IdoBH123/Temperature-Control/Project - Temp Control - Ohad, Rafi and Ido.pdf

# מעבדת חשמל ואלקטרוניקה 2

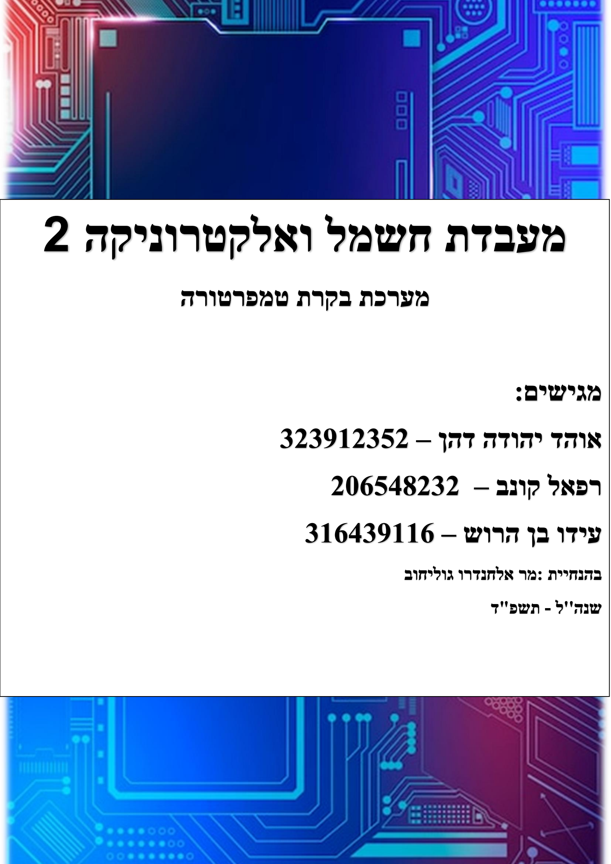
[picture p1: page 1]

# מערכת בקרת טמפרטורה

# מגישים:

# אוהד יהודה דהן – 323912352

# רפאל קונב – 206548232

# עידו בן הרוש – 316439116

## בהנחיית :מר אלחנדרו גוליחוב

## שנה''ל - תשפ"ד

מבוא
- מקדמה

הפרויקט שבחרנו הוא מערכת בקרת מיזוג )טמפ'( ה"נשלטת" על ידי קלט המשתמש שמכתיב מה יהיו תנאי החדר הרצויים.

- בחירת הנושא

לאחר חשיבה ממושכת, בחרנו בנושא זה מכיוון שחשנו מאותגרים משימוש ברכיבים חדשים ולא מוכרים וראינו בזאת כהזדמנות פז להעשיר את הידע שלנו כפרויקטורים ומהנדסים.

יתר על כן, רצינו לבחור בנושא אשר משתמש בידע קודם שלנו מקורסים אחרים )כגון מידול וסימולציה של מערכות דינמיות, מיתוג, תקבילית( על ידי שימוש פיזי ברכיבים שנלמדו רק באופן תיאורטי בהרצאות )כגון ממירים, מערכות צירופים, מגברי שרת וכו'(.

- ציפיות ראשוניות ומטרה

הציפיות שלנו הן שנעשיר את הידע שלנו ו"נצא" מהפרויקט כמהנדסים טובים יותר, שנתמודד בהצלחה עם עבודה בצוות, לווא דווקא עם אנשים בעלי אותו "קו חשיבה" ,ונלמד להיות מכילים וגמישים מבחינת עבודה בצוות, וכמובן שנדע לעסוק טוב יותר עם רכיבים אלקטרוניים נפוצים בתעשייה.

מטרתנו הסופית היא בניית מערכת אוטונומית ללא תקלות אשר שולטת באקלים בחדר מקרוב ומרחוק.

תוכן עניינים

## Contents

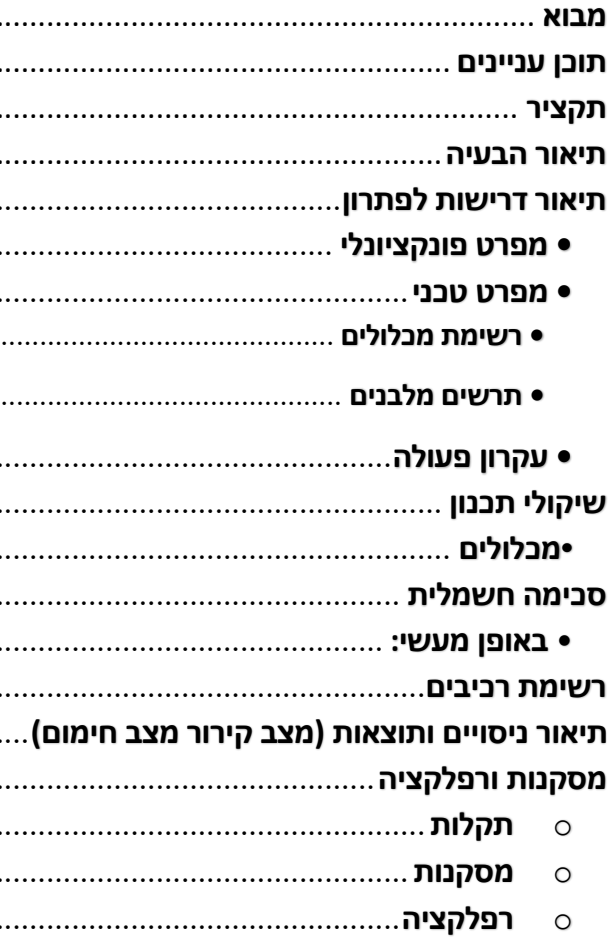
[picture p2: figure]

- רשימת מכלולים 5 |
- תרשים מלבנים 5 |

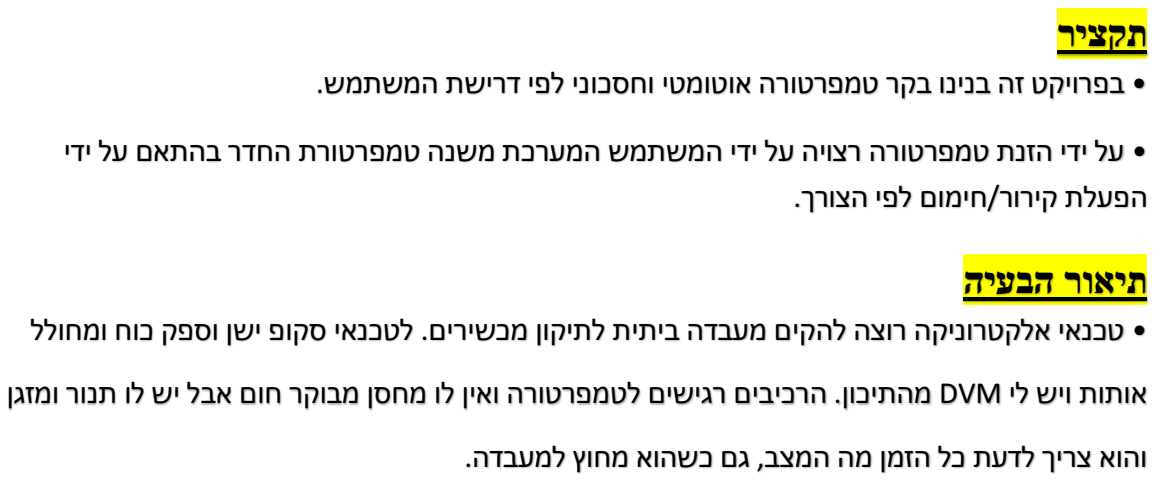
[picture p3: figure]
תקציר; הפעלת קירור/חימום לפי הצורך.; תיאור הבעיה

- בפרויקט זה בנינו בקר טמפרטורה אוטומטי וחסכוני לפי דרישת המשתמש.
- על ידי הזנת טמפרטורה רצויה על ידי המשתמש המערכת משנה טמפרטורת החדר בהתאם על ידי
- טכנאי אלקטרוניקה רוצה להקים מעבדה ביתית לתיקון מכשירים. לטכנאי סקופ ישן וספק כוח ומחולל

אותות ויש לי DVM מהתיכון. הרכיבים רגישים לטמפרטורה ואין לו מחסן מבוקר חום אבל יש לו תנור ומזגן

והוא צריך לדעת כל הזמן מה המצב, גם כשהוא מחוץ למעבדה.

נחלק את הבעיה לבעיות הנדסיות:

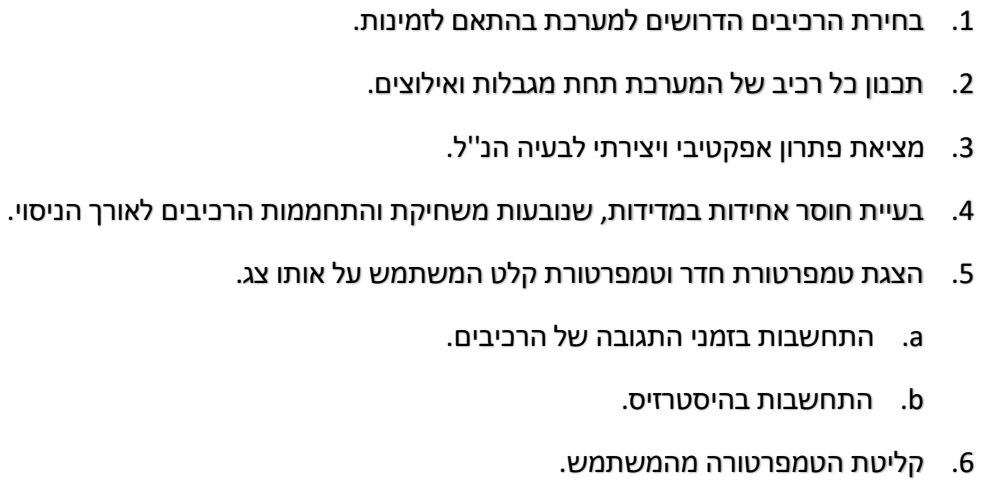
[picture p4: figure]
a. התחשבות בזמני התגובה של הרכיבים.; b. התחשבות בהיסטרזיס.; .6 קליטת הטמפרטורה מהמשתמש.

.1 בחירת הרכיבים הדרושים למערכת בהתאם לזמינות.

.2 תכנון כל רכיב של המערכת תחת מגבלות ואילוצים.

.3 מציאת פתרון אפקטיבי ויצירתי לבעיה הנ''ל.

.4 בעיית חוסר אחידות במדידות, שנובעות משחיקת והתחממות הרכיבים לאורך הניסוי.

.5 הצגת טמפרטורת חדר וטמפרטורת קלט המשתמש על אותו צג.

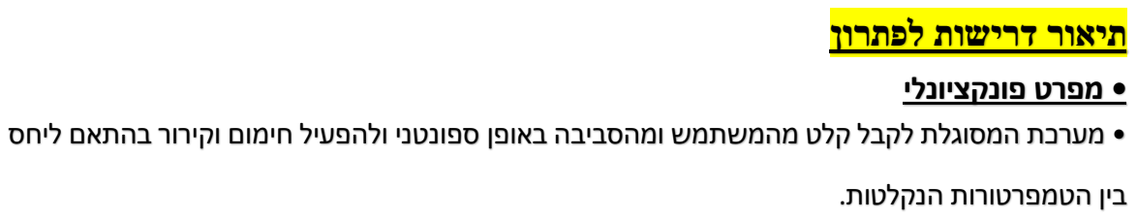
[picture p5: figure]
תיאור דרישות לפתרון; • מפרט פונקציונלי; בין הטמפרטורות הנקלטות.

- מערכת המסוגלת לקבל קלט מהמשתמש ומהסביבה באופן ספונטני ולהפעיל חימום וקירור בהתאם ליחס
- הצגת הטמפרטורות על צג אשר מחליף בין הצגת הטמפרטורה בחדר ובין הטמפרטורה הרצויה על ידי

המשתמש כל מספר שניות באופן אוטומטי, ואפשרות להצגת הטמפרטורה הרצויה על ידי המשתמש בלבד.

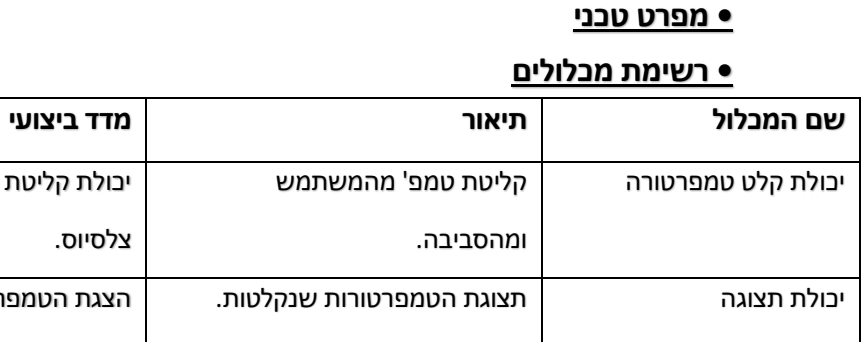
[picture p6: figure]
• מפרט טכני; • רשימת מכלולים; שם המכלול תיאור מדד ביצועי
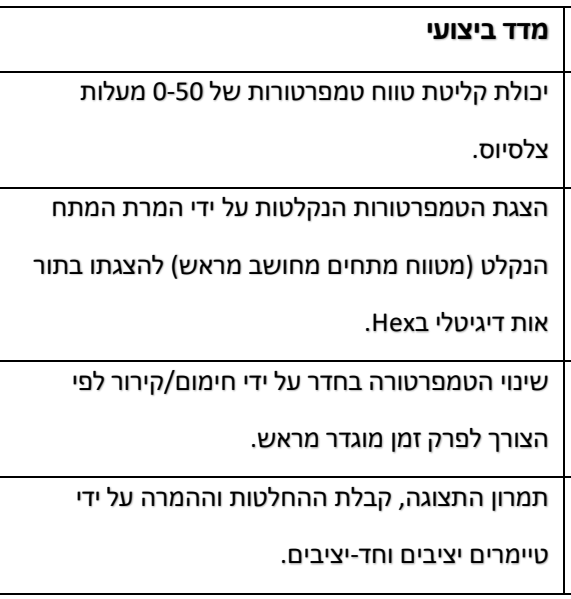
[picture p7: figure]

יכולת קליטת טווח טמפרטורות של 0-50 מעלות צלסיוס. | ומהסביבה. | יכולת קלט טמפרטורה קליטת טמפ' מהמשתמש
הנקלט )מטווח מתחים מחושב מראש( להצגתו בתור אות דיגיטלי בHex. | | יכולת תצוגה תצוגת הטמפרטורות שנקלטות. הצגת הטמפרטורות הנקלטות על ידי המרת המתח
הצורך לפרק זמן מוגדר מראש. | | יכולת קבלת החלטות שינוי הטמפרטורה בחדר. שינוי הטמפרטורה בחדר על ידי חימום/קירור לפי
טיימרים יציבים וחד-יציבים. | | יכולת תזמון ו-Switching תמרון רכיבי המעגל. תמרון התצוגה, קבלת ההחלטות וההמרה על ידי
- תרשים מלבנים

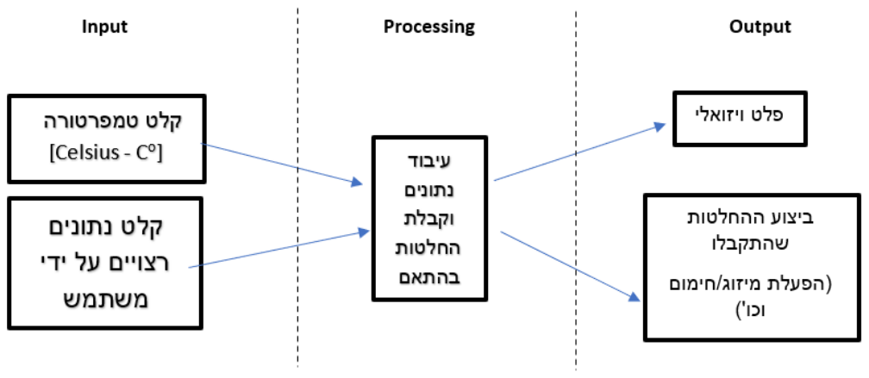
[picture p8: figure]

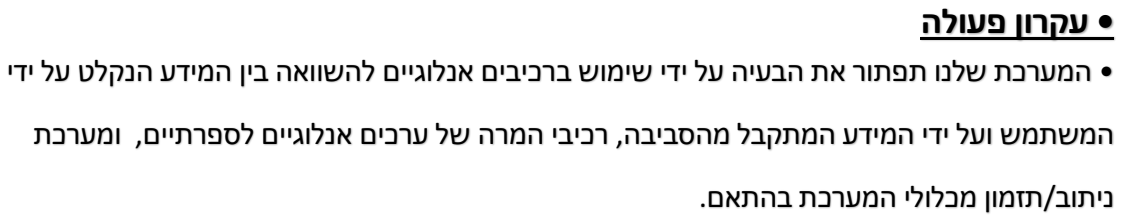
[picture p9: figure]
• עקרון פעולה; ניתוב/תזמון מכלולי המערכת בהתאם.

- המערכת שלנו תפתור את הבעיה על ידי שימוש ברכיבים אנלוגיים להשוואה בין המידע הנקלט על ידי

המשתמש ועל ידי המידע המתקבל מהסביבה, רכיבי המרה של ערכים אנלוגיים לספרתיים, ומערכת

- במרווחי זמן ידועים, המערכת קולטת מידע מהסביבה ומהמשתמש, תעבד ותשווה את הנתונים הנקלטים

ותקבל החלטות בהתאם, כלומר תבחר אם לחמם או לקרר את החדר לפי הצורך. בנוסף, תציג המערכת את

הנתונים הנקלטים ואת השינויים המתרחשים במרווחי הזמן הידועים.

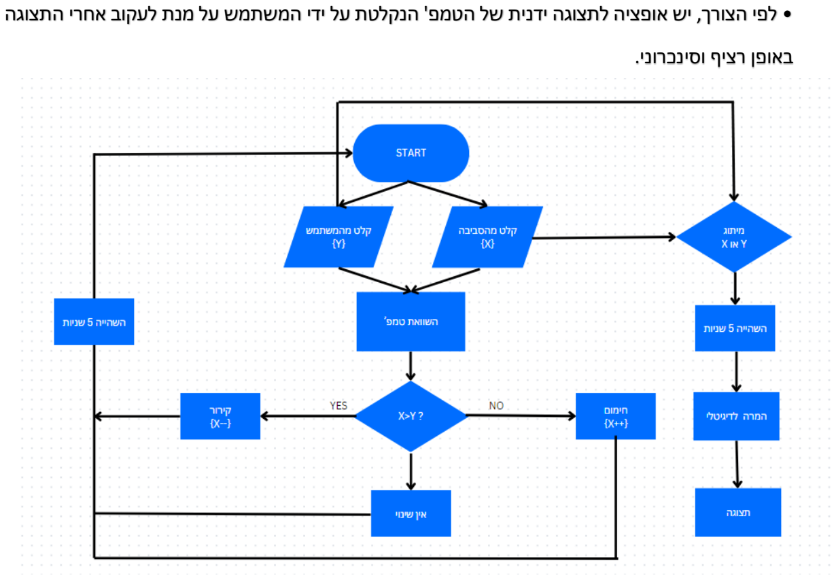
[picture p10: figure]
באופן רציף וסינכרוני.

- לפי הצורך, יש אופציה לתצוגה ידנית של הטמפ' הנקלטת על ידי המשתמש על מנת לעקוב אחרי התצוגה

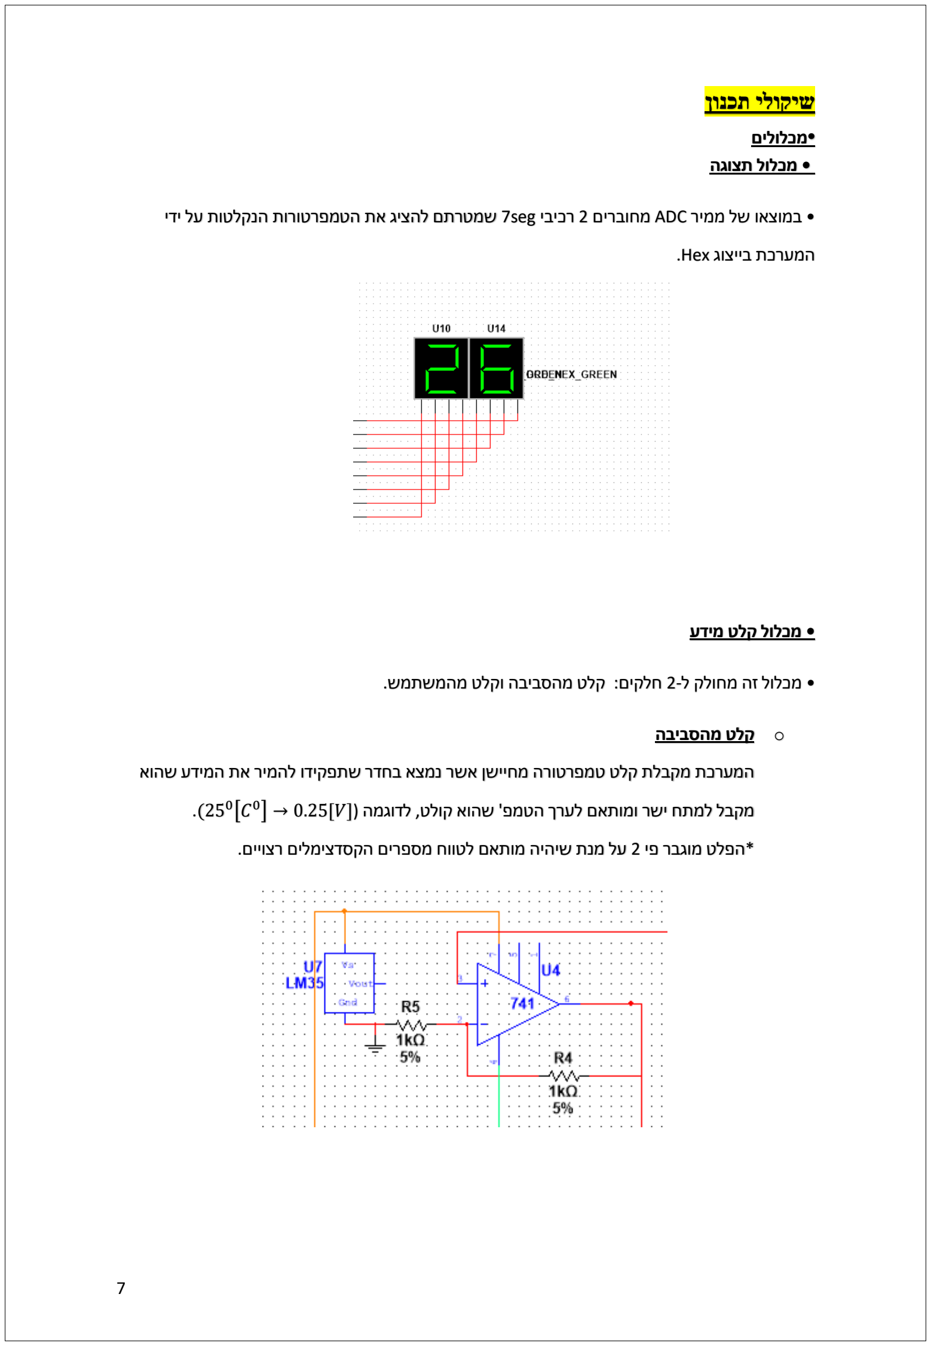
[picture p11: page 7]

שיקולי תכנון

•מכלולים
- מכלול תצוגה
- במוצאו של ממיר ADC מחוברים 2 רכיבי seg7 שמטרתם להציג את הטמפרטורות הנקלטות על ידי

המערכת בייצוג Hex.

- מכלול קלט מידע
- מכלול זה מחולק ל2- חלקים: קלט מהסביבה וקלט מהמשתמש.
- קלט מהסביבה

המערכת מקבלת קלט טמפרטורה מחיישן אשר נמצא בחדר שתפקידו להמיר את המידע שהוא

0 | מקבל למתח ישר ומותאם לערך הטמפ' שהוא קולט, לדוגמה ) 25)
ൣC

0
. | ൧ → 0.25[V]

*הפלט מוגבר פי 2 על מנת שיהיה מותאם לטווח מספרים הקסדצימלים רצויים.

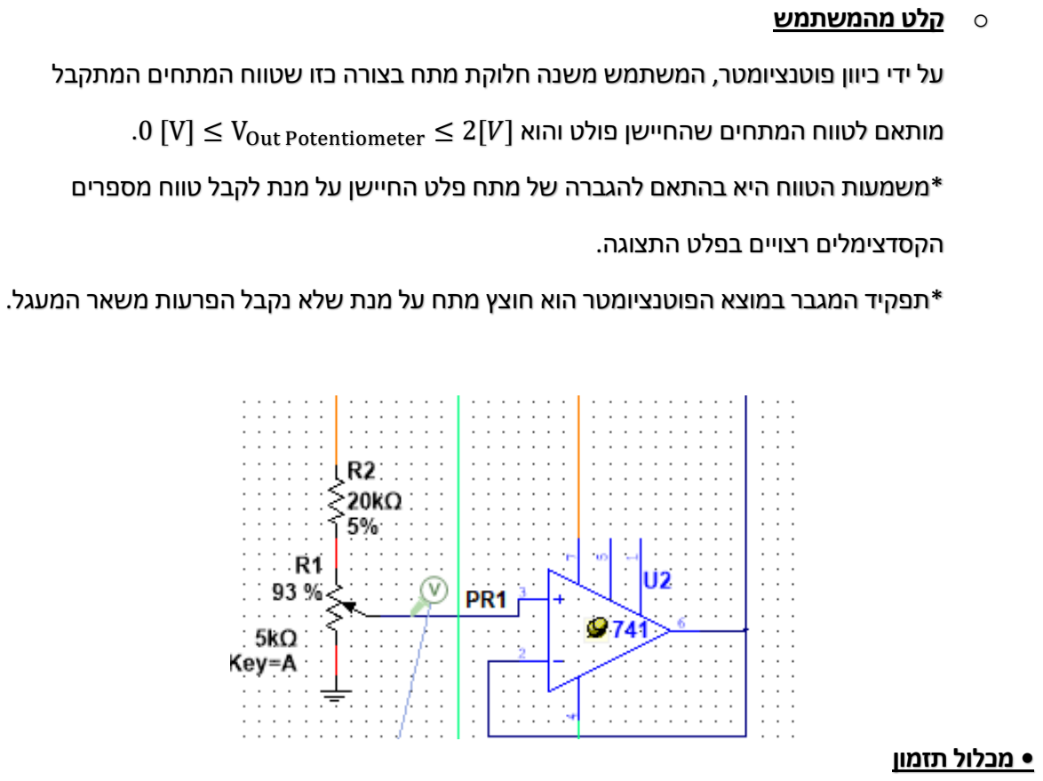
[picture p12: figure]
• קלט מהמשתמש; הקסדצימלים רצויים בפלט התצוגה.; • מכלול תזמון

על ידי כיוון פוטנציומטר, המשתמש משנה חלוקת מתח בצורה כזו שטווח המתחים המתקבל

מותאם לטווח המתחים שהחיישן פולט והוא []2 ≥ Potentiometer VOut] ≤ V [.0

*משמעות הטווח היא בהתאם להגברה של מתח פלט החיישן על מנת לקבל טווח מספרים

*תפקיד המגבר במוצא הפוטנציומטר הוא חוצץ מתח על מנת שלא נקבל הפרעות משאר המעגל.

- שלושה רכיבי 555LM, כאשר שניים מהם מחוברים באופן חד-יציב והנותר מחובר באופן אל-יציב.

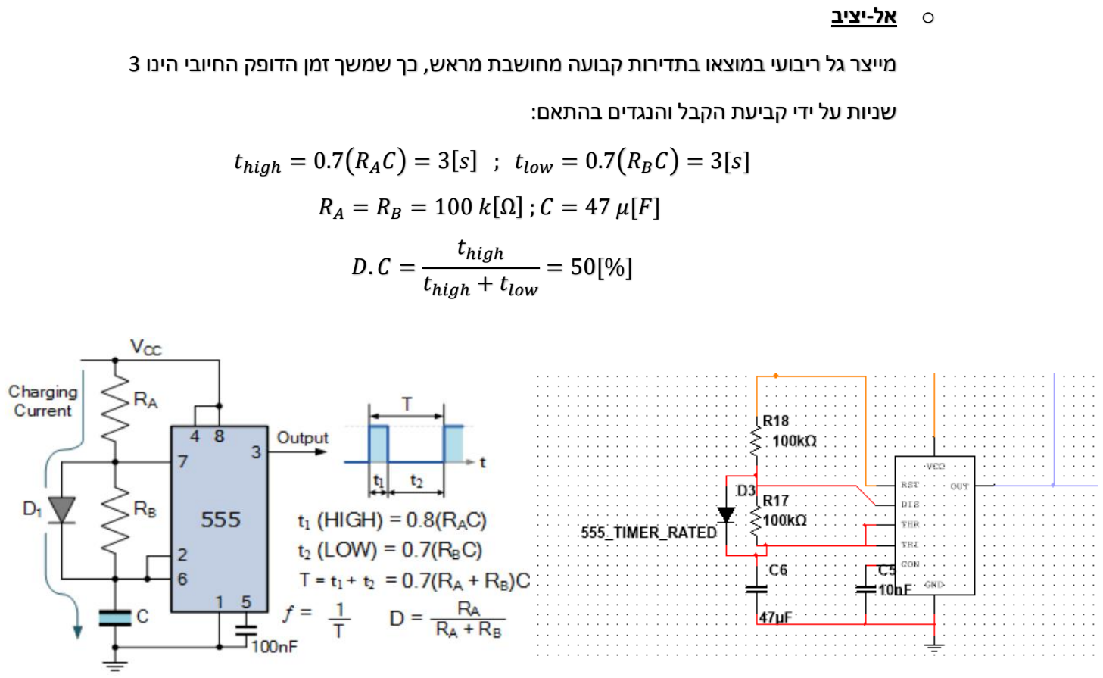
[picture p13: figure]
• אל-יציב; שניות על ידי קביעת הקבל והנגדים בהתאם:; tℎigℎ; tℎigℎ + tlow

מייצר גל ריבועי במוצאו בתדירות קבועה מחושבת מראש, כך שמשך זמן הדופק החיובי הינו 3

tℎigℎ = 0.7൫RAC൯ = 3[s] ; tlow = 0.7൫RBC൯ = 3[s]

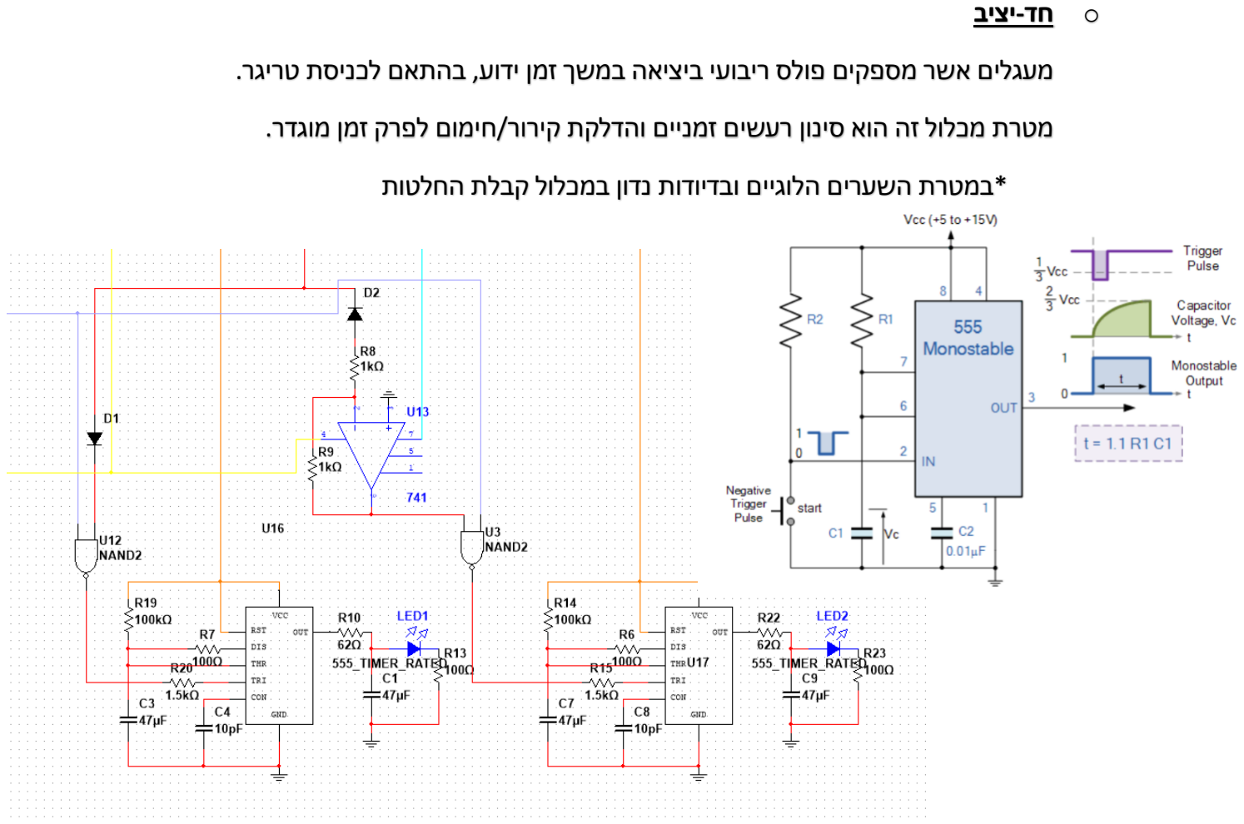
[picture p14: figure]
• חד-יציב

מעגלים אשר מספקים פולס ריבועי ביציאה במשך זמן ידוע, בהתאם לכניסת טריגר.

מטרת מכלול זה הוא סינון רעשים זמניים והדלקת קירור/חימום לפרק זמן מוגדר.

*במטרת השערים הלוגיים ובדיודות נדון במכלול קבלת החלטות

- מכלול עיבוד נתונים וקבלת החלטות
- מכלול זה מורכב מממסר V5 , דיודות, משווים שערים לוגיים ומפסק ידני. נדון במטרת כל אחד בנפרד:

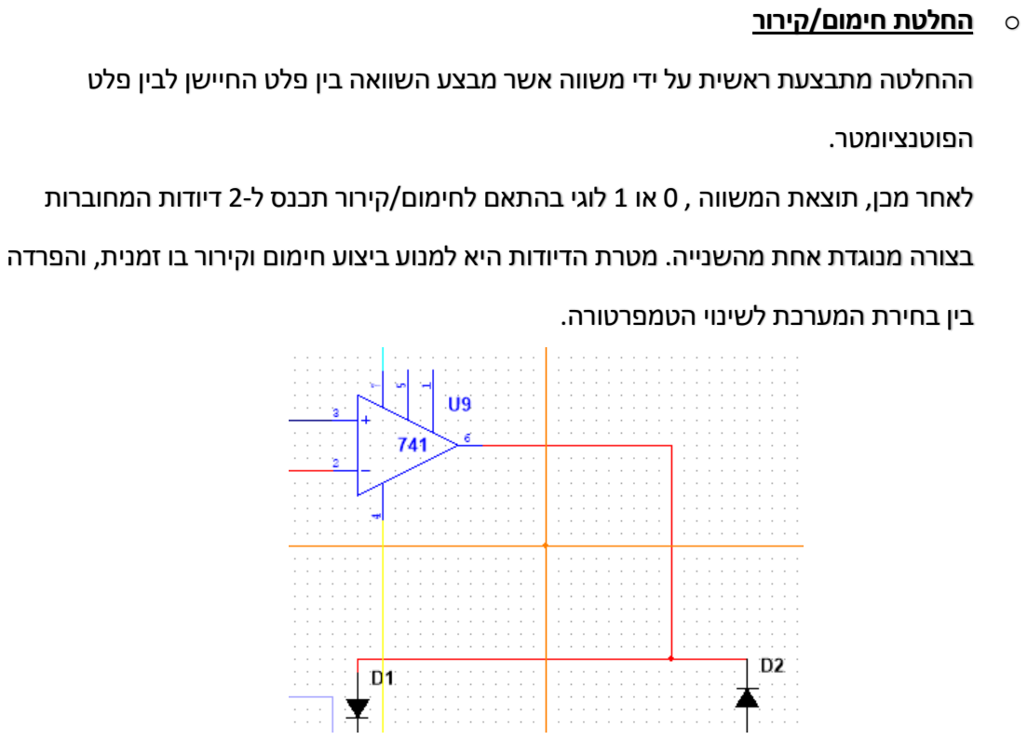
[picture p15: figure]
• החלטת חימום/קירור; הפוטנציומטר.; בין בחירת המערכת לשינוי הטמפרטורה.

ההחלטה מתבצעת ראשית על ידי משווה אשר מבצע השוואה בין פלט החיישן לבין פלט

לאחר מכן, תוצאת המשווה , 0 או 1 לוגי בהתאם לחימום/קירור תכנס ל2- דיודות המחוברות

בצורה מנוגדת אחת מהשנייה. מטרת הדיודות היא למנוע ביצוע חימום וקירור בו זמנית, והפרדה

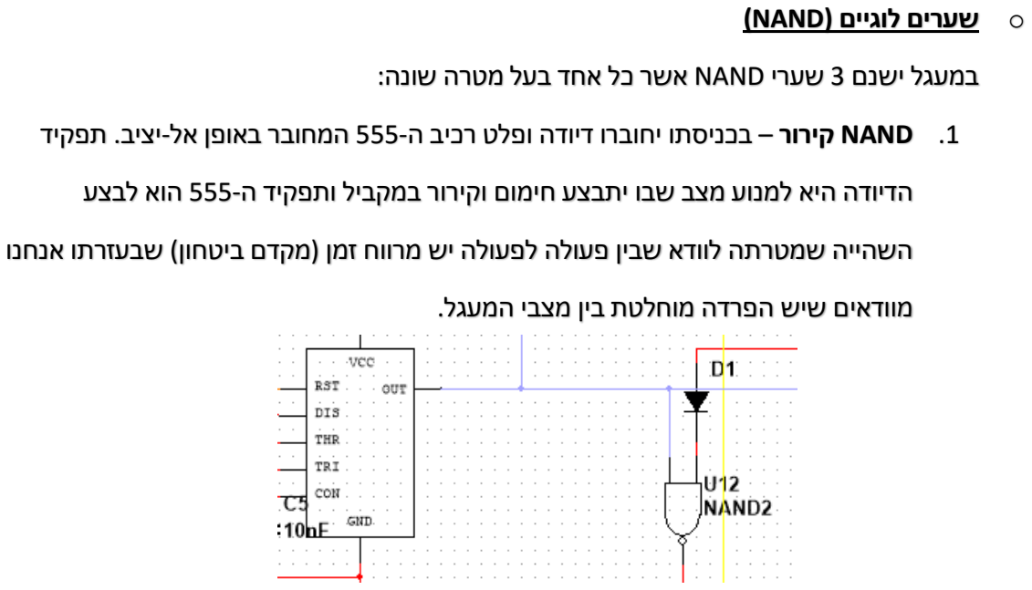
[picture p16: figure]
• שערים לוגיים )NAND)

במעגל ישנם 3 שערי NAND אשר כל אחד בעל מטרה שונה:

.1 NAND קירור – בכניסתו יחוברו דיודה ופלט רכיב ה555- המחובר באופן אל-יציב. תפקיד

הדיודה היא למנוע מצב שבו יתבצע חימום וקירור במקביל ותפקיד ה555- הוא לבצע

השהייה שמטרתה לוודא שבין פעולה לפעולה יש מרווח זמן )מקדם ביטחון( שבעזרתו אנחנו

מוודאים שיש הפרדה מוחלטת בין מצבי המעגל.

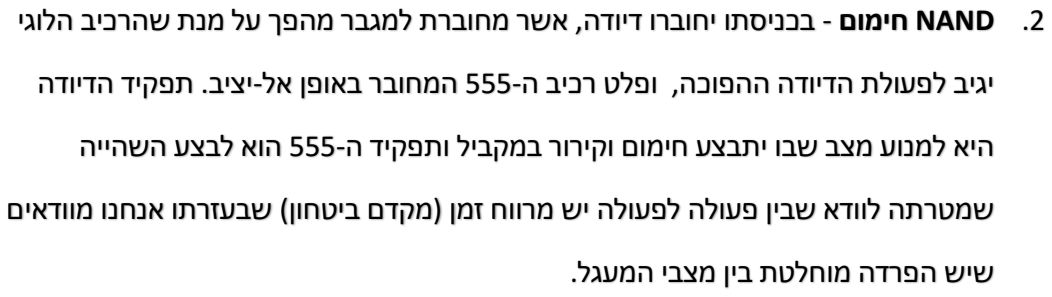
[picture p17: figure]
שיש הפרדה מוחלטת בין מצבי המעגל.

.2 NAND חימום - בכניסתו יחוברו דיודה, אשר מחוברת למגבר מהפך על מנת שהרכיב הלוגי

יגיב לפעולת הדיודה ההפוכה, ופלט רכיב ה555- המחובר באופן אל-יציב. תפקיד הדיודה

היא למנוע מצב שבו יתבצע חימום וקירור במקביל ותפקיד ה555- הוא לבצע השהייה

שמטרתה לוודא שבין פעולה לפעולה יש מרווח זמן )מקדם ביטחון( שבעזרתו אנחנו מוודאים

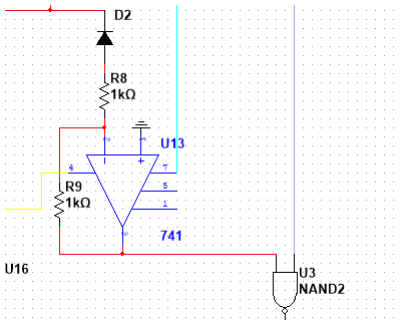
[picture p18: figure]

.3 NAND" מעבר מאוטומטי לידני" – NAND אשר לכניסתו מחובר הרב רטט אל-יציב,

שמטרתו לגרום להחלפת פלט התצוגה מקלט החיישן לקלט המשתמש ובחזרה כל פרק זמן

קבוע, ומפסק שמטרתו למנוע את ההחלפה האוטומטית והצגת טמפרטורת המשתמש

בלבד. משמעות מניעת ההחלפה האוטומטית היא על מנת שבמידה ונרצה לעקוב בצורה

רציפה אחרי שינוי התצוגה בהתאם לשינוי הפוטנציומטר , נוכל להפעיל את המפסק ולכבות

אותו כאשר נסיים לשנות את הפוטנציומטר.

*ביציאתו של השער הלוגי נחבר משווה אשר משמש אותנו אך ורק בבניית המעגל במעשי,

זאת מכיוון שביציאת שער לוגי מסוג TTL אנחנו לא מקבלים ערכים ברורים של 1 ו0- לוגי,

אלא טווח ערכים אשר נקבע מראש על ידי היצרן. על ידי המשווה אנחנו מגדירים מחדש את

1 לוגי כ5- וולט ו0- לוגי כ0- וולט. יציאת המשווה תתחלף בין 0 לוגי ל1- לוגי כל פרק זמן

מוגדר אלא אם המפסק סגור.

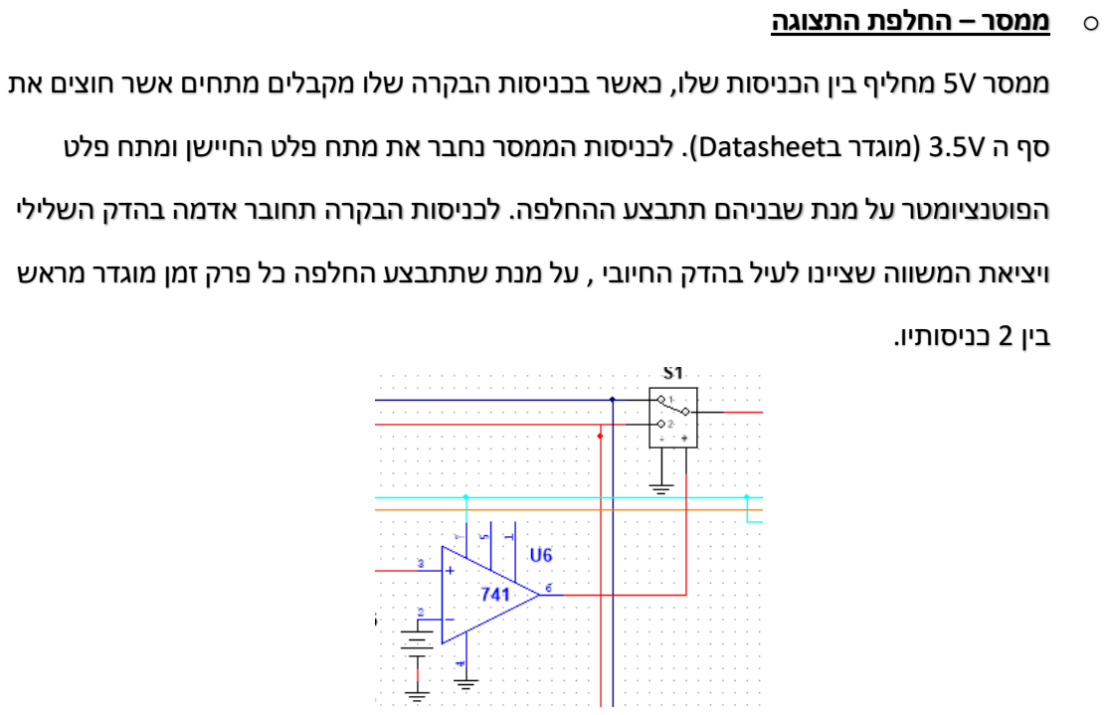
[picture p19: figure]
• ממסר – החלפת התצוגה; בין 2 כניסותיו.

ממסר V5 מחליף בין הכניסות שלו, כאשר בכניסות הבקרה שלו מקבלים מתחים אשר חוצים את

סף ה V3.5( מוגדר בDatasheet). לכניסות הממסר נחבר את מתח פלט החיישן ומתח פלט

הפוטנציומטר על מנת שבניהם תתבצע ההחלפה. לכניסות הבקרה תחובר אדמה בהדק השלילי

ויציאת המשווה שציינו לעיל בהדק החיובי , על מנת שתתבצע החלפה כל פרק זמן מוגדר מראש

- מכלול המרה וחישוב מידע

מכלול זה בנוי ממגברי שרת, שמטרתם להגביר את המתח בכמות כזו שתתאים כך שהתצוגה תפלוט ערכים

מתאימים לקלטי הטמפ' בHEX. בנוסף, ישנו ממיר ADC הממיר מתח לאות דיגיטלי ביציאה המוצג על ידי

מספר בינארי בעל 8 סיביות, כך שכל 4 סיביות נכנסות לתצוגת segHex7 אחר.

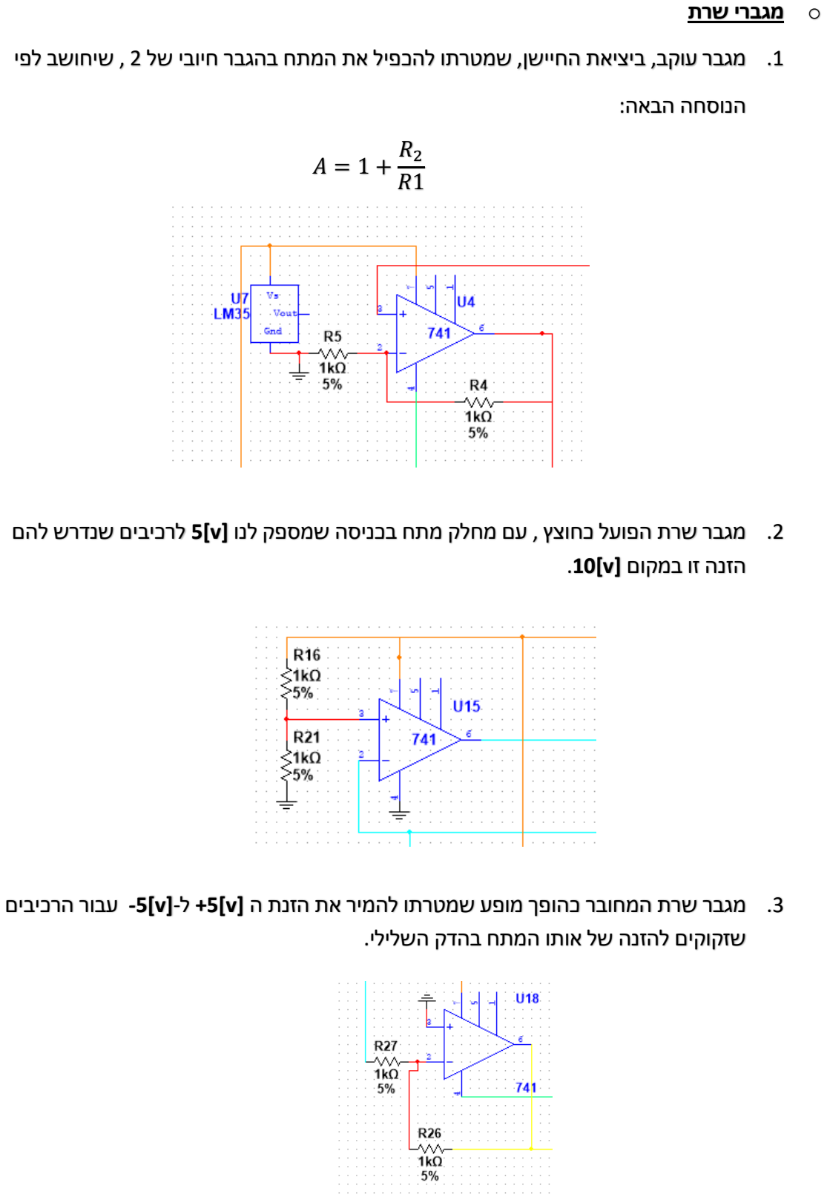
[picture p20: figure]
• מגברי שרת; הנוסחה הבאה:; הזנה זו במקום [v[.10; שזקוקים להזנה של אותו המתח בהדק השלילי.

.1 מגבר עוקב, ביציאת החיישן, שמטרתו להכפיל את המתח בהגבר חיובי של 2 , שיחושב לפי

.2 מגבר שרת הפועל כחוצץ , עם מחלק מתח בכניסה שמספק לנו [v[5 לרכיבים שנדרש להם

.3 מגבר שרת המחובר כהופך מופע שמטרתו להמיר את הזנת ה [v[+5 ל-[v[-5 עבור הרכיבים

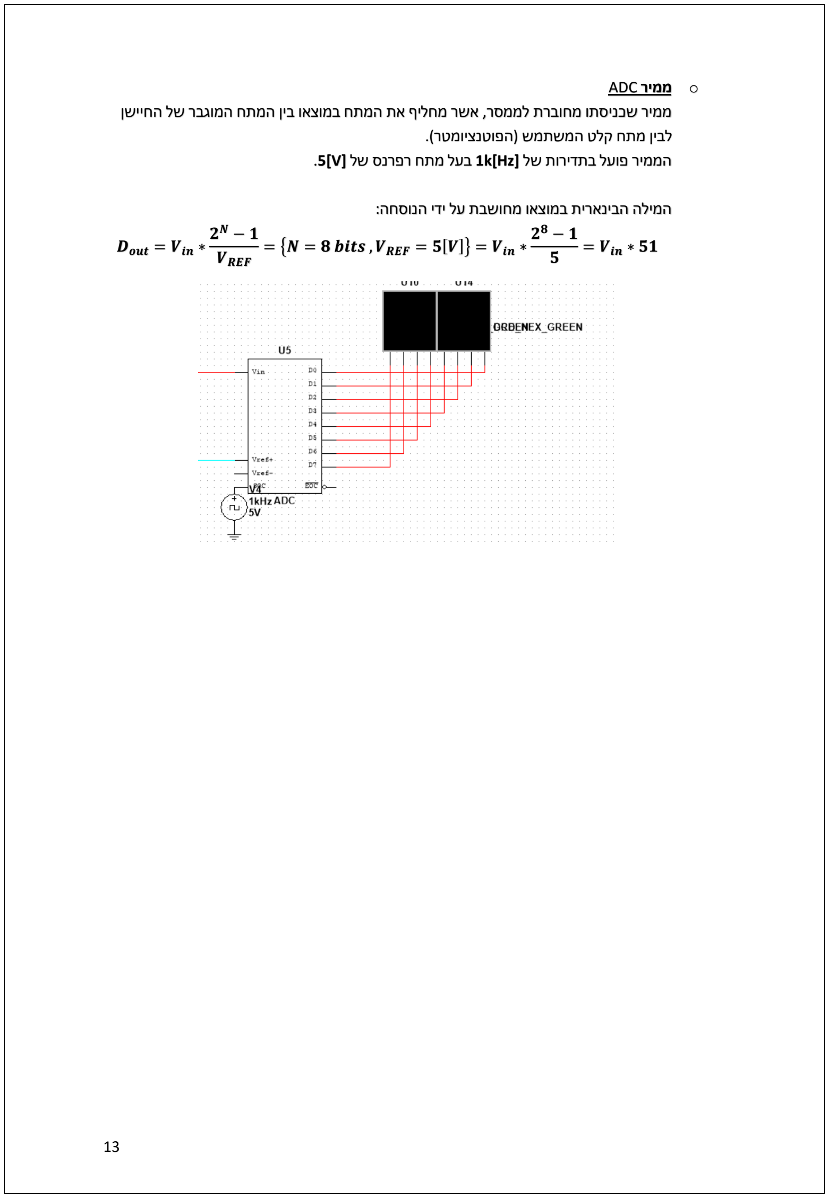
[picture p21: page 13]

ADC | ממיר | o
ממיר שכניסתו מחוברת לממסר, אשר מחליף את המתח במוצאו בין המתח המוגבר של החיישן לבין מתח קלט המשתמש )הפוטנציומטר(. הממיר פועל בתדירות של [Hz[k1 בעל מתח רפרנס של [V[.5

המילה הבינארית במוצאו מחושבת על ידי הנוסחה:

Dout = Vin ∗

2

N − 1

VREF

= ൛N = 8 bits ,VREF = 5[V]ൟ = Vin ∗

2

8 − 1
5

= Vin ∗ 51

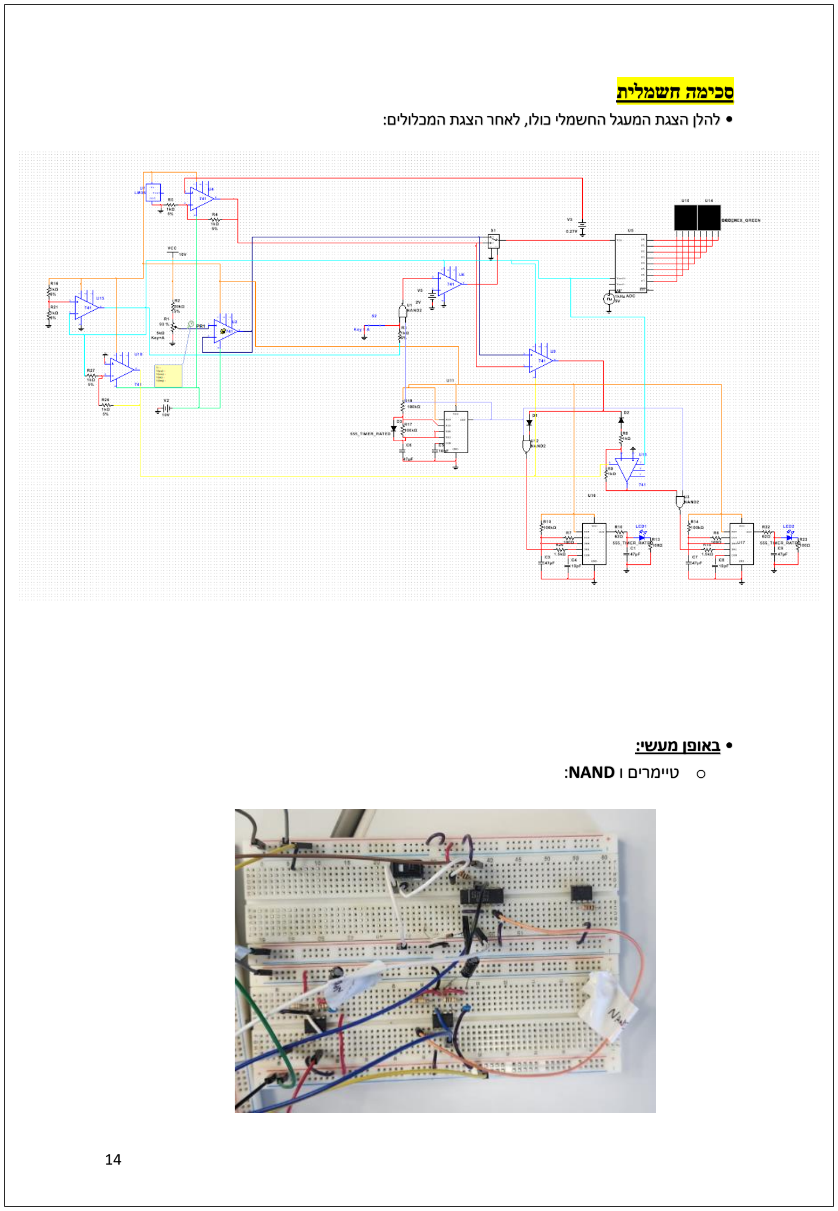
[picture p22: page 14]

סכימה חשמלית

- להלן הצגת המעגל החשמלי כולו, לאחר הצגת המכלולים:
- באופן מעשי:
- טיימרים ו NAND:

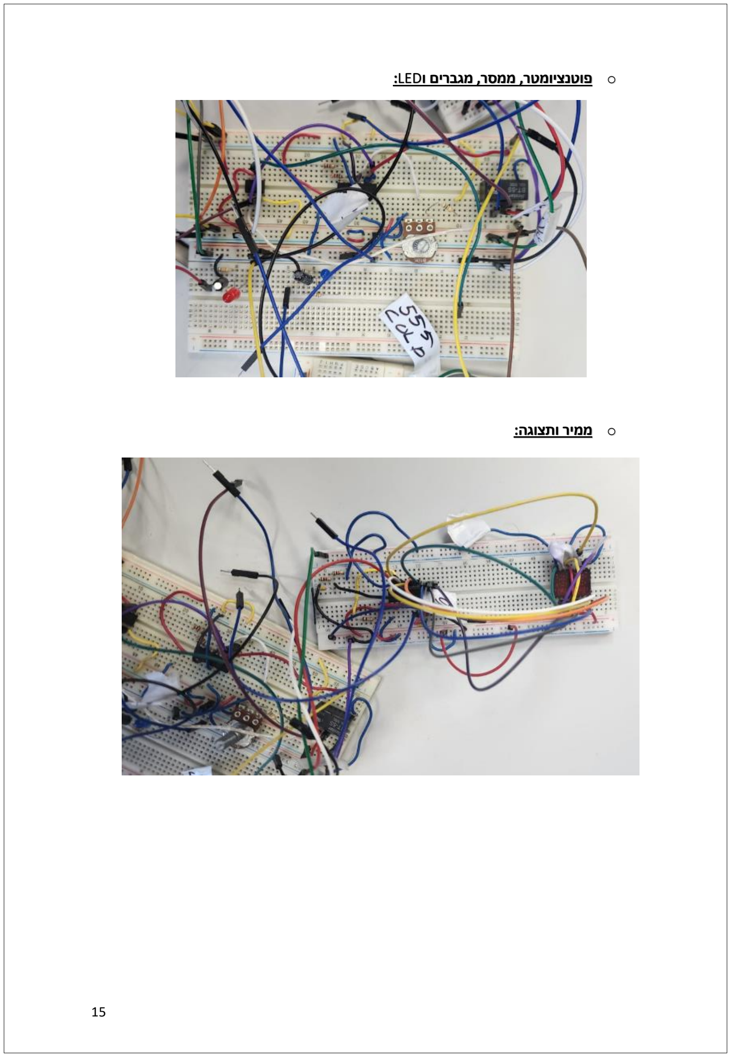
[picture p23: page 15]

- פוטנציומטר, ממסר, מגברים וLED:
- ממיר ותצוגה:

רשימת רכיבים

### סוג תת- סוג דגם / ערך

מגברים ושאר רכיבי IC מגבר אופרטיבי AMP .OP 741LM( ברירת מחדל( מגברים ושאר רכיבי IC מגבר אופרטיבי AMP .OP Quad 324LM דיודה דיודה רגילה 41481N( ברירת מחדל( LED LED רגיל )ברירת המחדל( 5 מ"מ לד צבע אדום )ברירת מחדל(
LED LED רגיל )ברירת המחדל( 5 מ"מ לד צבע כחול חוטי קצר 10 cm זכר-זכר male-male חוטי קצר 20cm( ברירת מחדל( זכר-זכר male-male מטריצה מטריצה רגילה מטריצה לרגילה -12GL

ממסר 5V ממסר

רגיל בודד S27/005-HFD או -5RS
)ישן(
NAND 7437 | xx74 | IC 74xx(x)
קבל nF 150
קבל nF 10
קבל pF 10
קבל µF 47
קבל µF 1
נגד רגיל )1/4 וואט 5%( KOhm 1
| | נגד

נגד משתנה מתכתי גדול
5 Kohm | למטריצה

נגד רגיל )1/4 וואט 5%( KOhm 20 נגד רגיל )1/4 וואט 5%( KOhm 5.1 נגד רגיל )1/4 וואט 5%( KOhm 3.9 נגד רגיל )1/4 וואט 5%( Ohm 100 נגד רגיל )1/4 וואט 5%( KOhm 1.5 נגד רגיל )1/4 וואט 5%( Ohm 62 נגד רגיל )1/4 וואט 5%( KOhm 100 נגד רגיל )1/4 וואט 5%( Mohm 1 נגד רגיל )1/4 וואט 5%( KOhm 100 מגברים ושאר רכיבי IC Timer) ברירת מחדל) 555LM

תיאור ניסויים ותוצאות )מצב קירור מצב חימום( לאחר הפעלת המעגל סיפקנו לו מתחים שונים בכניסתו, אחד מהחיישן והשני מהפוטנציומטר.

להלן דוגמאות עבור 2 המצבים האפשריים במעגל:

- חימום
עבור מקרה שבו מתח המשתמש גדול ממתח החיישן המערכת תדליק LED אדום המייצג חימום במשך 3 שניות וכל פרק זמן כזה המערכת תבדוק מחדש. בנוסף, את המתחים המערכת תציג ביציאה וגם הם יתחלפו בפרקי זמן הנ''ל.

### 0 עבור מתח משתמש [

]: | חיישן | ומתח | , Vin=0.09 [V] -> 9[C ⁰ V=0.04/2[V] -> 4[C
- קירור
עבור מקרה שבו מתח המשתמש קטן ממתח החיישן המערכת תדליק LED כחול המייצג קירור במשך 3 שניות וכל פרק זמן כזה המערכת תבדוק מחדש. בנוסף, את המתחים המערכת תציג ביציאה וגם הם יתחלפו בפרקי זמן הנ''ל. *עבור המחשה ומקרי קצה ובדיקה שהמעגל לא נשרף תחת מתחים חריגים, בדקנו עבור מתח כניסה גבוה מהטווח הרצוי.

### 0 עבור מתח חיישן [

]: | משתמש | ומתח | , Vin=0.64/2 [V] -> 64[C ⁰ V=0.21 [V] -> 21[C

תצוגת חיישן תצוגת משתמש פעולת שינוי טמפ' )LED)

מסקנות ורפלקציה
- תקלות שנתקלנו בהן בעת בניית המעגל: .1 במהלך בניית המעגל המעשי שכלל את הממיר D/A וחיבורו למקור מתח ולתצוגת 7 SEG מסוג HEX . נתקלנו במספר בעיות שנבעו בתחילה מממיר שהיה שרוף מלכתחילה. .2 חיבור הרכיבים התקולים גררו בעיות שיבושים במהלכי המדידה והבדיקה ובנוסף בחיבורים עתידיים. לאחר החלפת הממיר, לממיר חדש לגמרי, בדקנו באמצעות מד מתח את היציאה וראינו שהא עובד כמצופה.
.3 במהלך בניית הפרויקט, כתוצאה מריבוי חוטי הקצר, נוצר בלבול וחוסר וודאות לגבי מהן היציאות והכניסות של כל רכיב. בעיה זו נפתרה בקלות כאשר קיצרנו את החיבורים שלנו ואת החיבורים הארוכים יותר סימנו על ידי צבעים אחידים וטייפ עם כיתוב מפורט לגבי כל מטרה
של חיבור.
.4 רכיבי ה- TTL – 555LM שסופקו לנו, היו רכיבים לא יציבים, מכיוון שהם היו בלוים, שחוקים ומיושנים, ונאלצנו להחליפם בתדירות גבוהה עד שקיבלנו רכיבים חדשים לגמרי. לאחר בדיקת הרכיבים החדשים לגמרי לא נתקלנו בבעיות נוספות. לעומת זאת, לאחר שימוש ברכיב פעמים מרובות עד הגשת הפרויקט באופן מעשי , אחד מתוך שלושת הטיימרים הנעשו בשימוש בפרויקט, הספיק להישרף, וברגע האחרון, באישור מרצה, קיבלנו הוראה להשתמש במחולל אותות במקום.
- מסקנות
.1 לאחר בניית המעגל והכנסת קלטים שונים לרכיבים הוכחנו שהמעגל תקין בבנייתו ומבצע את הפעולה הנדרש בצורה טובה מאוד. .2 לאחר התקלות בהרבה רכיבים פגומים ומטריצות משומשות מאוד הסקנו שחובה לבדוק כל רכיב, מטריצה, ולעיתים רחוקות גם כבלי מדידה לפני חיבורם למעגל ולפני שמשתמשים בהם למטרה הרצויה.
.3 חוסר דיוק של הממיר והמגברים הוו אתגר, ולהבא, נעבוד עם מתחים גדולים יותר ממה שעבדנו על מנת הקטנת השגיאה והזנחת השפעת הרעשים. .4 יש לוודא שכל חלק במעגל עובד כמו שצריך בנפרד ולהשוותו עם נתוני היצרן ותוצאות בסכימה התאורטית.
.5 לאחר חיבור מכלולים יש לוודא גם אותם בנפרד ורק לאחר מכן לחבר את המעגל כולו, כך נוכל לזהות בקלות יותר תקלות אפשריות במעגל. .6 מומלץ לסמן במעגל באופן מסודר יציאות וכניסות רכיבים על מנת למנוע בלבול )צבעים, טייפ, מכלולים לחוד( .
.7 בחיבור רכיבים קרובים מומלץ להשתמש בחוטי קצר קצרים אשר לא יתנתקו בקלות ויגרמו לאובדן חיבורים.

- רפלקציה
אוהד
במהלך בניית הפרויקט נתקלתי בהמון קשיים. דפוס החשיבה שלי היה שונה משל חבריי לקבוצה וגם לוחות הזמנים שלנו וזה גרם לעבודה בצוות להיות מאוד מגוונת.
בנוסף, כתוצאה מהפער הארוך בין סוף סמסטר קודם לתחילת הסמסטר הנוכחי הייתי "חלוד" לגבי כל מה שקשור לבנייה מעשית של הפרויקט. לעומת זאת, הניסיון הרב שצברתי, המחקר הרב, בניית המולטיסים, קריאת ההרצאות באלק' תקבילית וספרתית, חיפוש רב בגוגל, גרמו ליכולות שלי להיות מחודדות יותר ויכולותיי הן טובות מתמיד.
מאוד נהניתי מהחוויה הזו, למדתי המון. אם יש משהו שהייתי עושה שונה בפרויקט כנראה שהייתי מנהל את הזמן שלי נכון יותר, בנוסף, הייתי מתעקש יותר על בניית המעגל בצורה אנלוגית.

רפי
פרויקט זה לימד אותי הרבה בין אם זה במובן של העבודה בקבוצה והין אם זה בעבודה פרקטית של תכנון ובניית של פרויקט אלקטרוני מהרעיון ועד לרכיבים האלקטרונים בעצמם. במהלך הפרויקט נתקענו בבעיות רבות בשל רעיונות שעובדים רק בתאוריה אך במציאות כשלו אך בתור קבוצה הצלחנו להתגבר על קשיים אלה ותגבשנו ביכולתנו לפתור בעיות הנדסיות בצורה טובה יותר.
בתהליך בניית הפרויקט השתפרה יכולתי בקריאת דקויות קטנות וסרטוטים מדפי נתונים ואף המבט שלי על התחום ברחב יותר של מערכות בקרה מתקדמות יותר התעצמה.

עידו
במהלך פרויקט זה חוויתי עבודת צוות הן בשלב תכנון המעגל והן בשלב המעשי, השילוב של השניים גרם לי להשתפר בפן המעשי שבו חששתי בתחילה שהוא יהיה לי יותר קשה , אך חבריי לקבוצה עזרו לי ונתנו לי את הכלים הדרושים להשתפר ולעזור. גם במהלך התקלות שנוצרו לנו כקבוצה עזרנו אחד לשני בהחלפת רכיבים או בחיבורם מחדש או בדיקת החיבורים במידה והיה צריך. בפרוייקט זה התנסיתי בנוסף בקריאת הרבה דפי נתונים של רכיבים והסתכלות על הנתונים אשר אני צריך ואמור להשתמש ולממש אותם, וזה בעצם גרם לי לשיפור הן באנגלית הטכנית והן באופן פרקטי הלכה למעשה של חיבורים ומעגלים חשמליים, ואף מוצרים הקיימים בתעשייה.
