IdoBH123/Temperature-Control/(list of files, drawings)

Other design files:
Final Project.ms14
